Tabzeen/avr_watering_system/Circuit/Manufacturing/JLC_Bom_Prod.xlsx

Comment | Designator | Footprint | JLCPCB Part #（optional）
ATMEGA328P-AU | 328P | 32.0A_L | C14877
100n | C0, C6, C7, C8, C9, C10, C11, C12, C13, C20, C21, C22, C23, C24, C25, C26, C27, C36, C37, C38 | CAPC1005X55 | C1525
470u | C1, C2, C31, C32 | CAPAE100X105 | C248607
47u | C3, C16, C17, C30 | CAPC3225X270 | C5440143
2u2 | C4, C5, C14, C15, C18, C19, C28, C29 | CAPC1608X90 | C23630
10u | C33, C34 | CAPC3216X180 | C13585
4n7 | C35 | CAPC1005X55 | C1538
CSTNE16M0V530000R0 | CLK | FP-CSTNE16M0V530000R0-MFG | C341521
SSC54 | D1, D2, D3 | DIOM7959X262 | C35722
744373965470 | L1, L2 | WE-LHMI_1365 | C5359268
744212221 | L3 | WE-SL1_L6.5W3.6H1.65 | C2662263
Red | LED1, LED2 | LEDC2012X90 | C84256
AO3400A | Q | FP-SOT23-IPC_C | C20917
10k | R1, R2, R3, R6, R7, R12 | RESC1005X40 | C25744
470R | R4, R5 | RESC1005X40 | C25117
RC2512JK-7W2R2L | R8, R9 | RC2512JK-7W2R2L-Footprint-1 | C705467
10R | R10, R11 | RESC2012X65 | C17415
150R | R13, R14 | RESC1005X40 | C25082
