Tabzeen/avr_watering_system/Enclosure/APWS_Case.FCStd

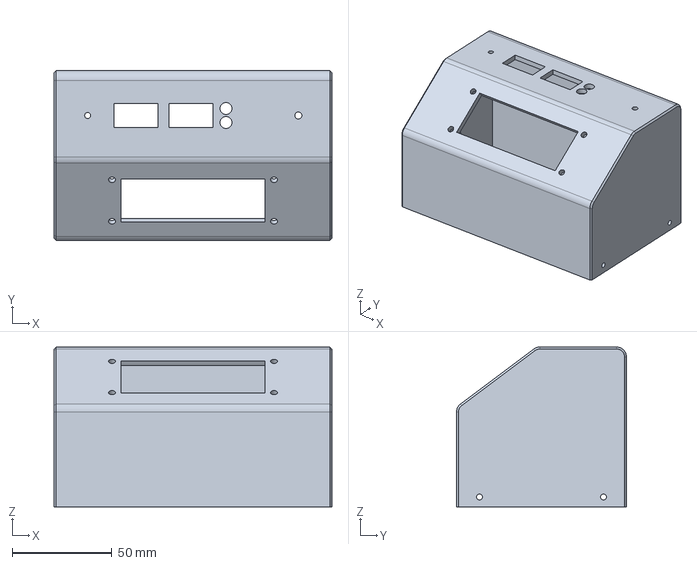
[picture p2: CAD file, 2026-05-23]
Enclosure/APWS_Case.FCStd
139.0 x 85.0 x 80.0 mm
