Tabzeen/avr_watering_system/Enclosure/APWS_Case_P1.stl

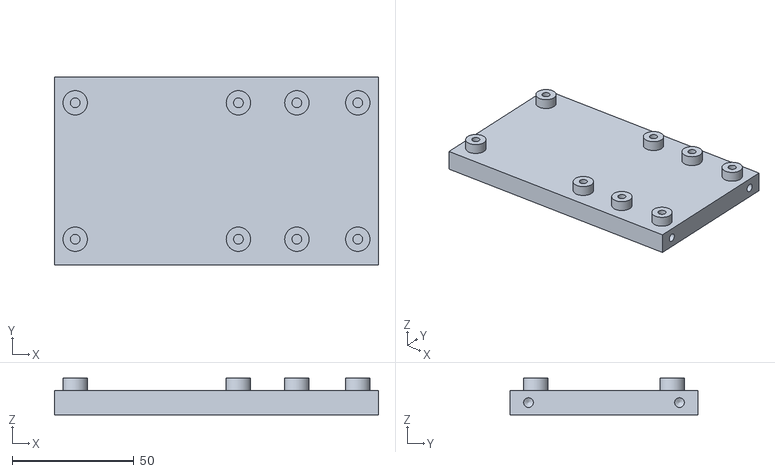
[picture p3: CAD file, 2026-05-23]
Enclosure/APWS_Case_P1.stl
133.0 x 77.0 x 15.0
