Tabzeen/avr_watering_system/(list of files, cad)

Other CAD files:
Enclosure/APWS_Case_P2.stl
