Tabzeen/avr_watering_system/(list of files, drawings)

Other design files:
Circuit/Altium/328P_Board.PcbDoc
Circuit/Altium/328P_Board.PrjPcb
Circuit/Altium/328P_Board.SchDoc
