Tabzeen/avr_watering_system/(commit log)

2026-05-23 Migrated data from internal Gitlab to public Gitlab
    [328P_Board.PcbDoc, 328P_Board.PrjPcb, 328P_Board.SchDoc, APWS_Case.FCStd, APWS_Case_P1.stl, APWS_Case_P2.stl, JLC_Bom_Prod.xlsx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]
2026-11-03 Update README.md with firmware structure details
    Added detailed sections about I/O drivers, component drivers, and orchestration for the AVR-Watering-System firmware.
